LuisPeMoraRod/TallerIntro-Proyecto2/(list of files, drawings)

Other design files:
Prueba shift.fzz
