LuisPeMoraRod/TallerIntro-Proyecto2/(commit log)

2019-11-05 Se agrega función movimiento circular (sin funcionar) antes de cambiar de branch
2019-11-06 Se agrega funcion de TurnTime
2019-11-06 Se agrega funcion de North y algunos cambios de velocidades
2019-11-09 IP para hotspot iPhone
2019-11-20 Adds code for temperature sensing
    [Prueba shift.fzz]
